awjlogan/emonTH3/models/12BH321P-GR.stp

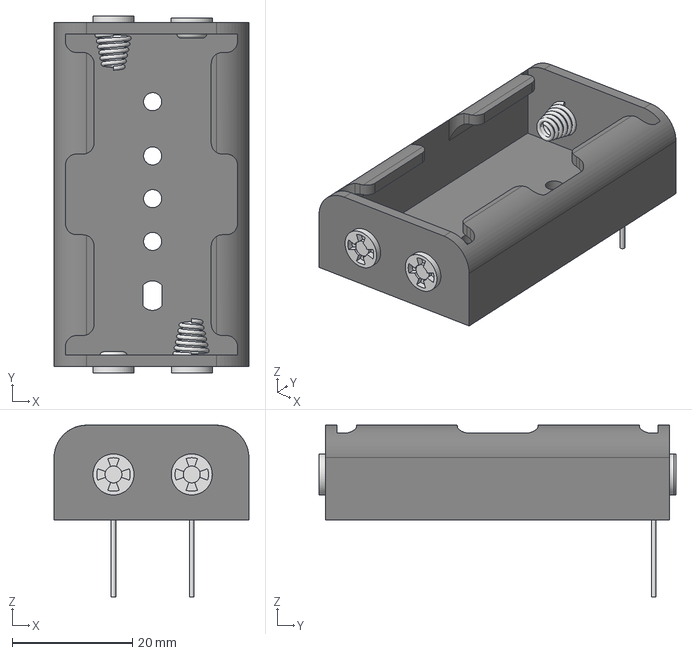
[picture p1: CAD file, 2024-12-10]
models/12BH321P-GR.stp
32.4 x 59.3 x 28.5 mm
