awjlogan/emonTH3/models/pxc_5441388_01_00_BCH-350H-6-GN_3D.stp

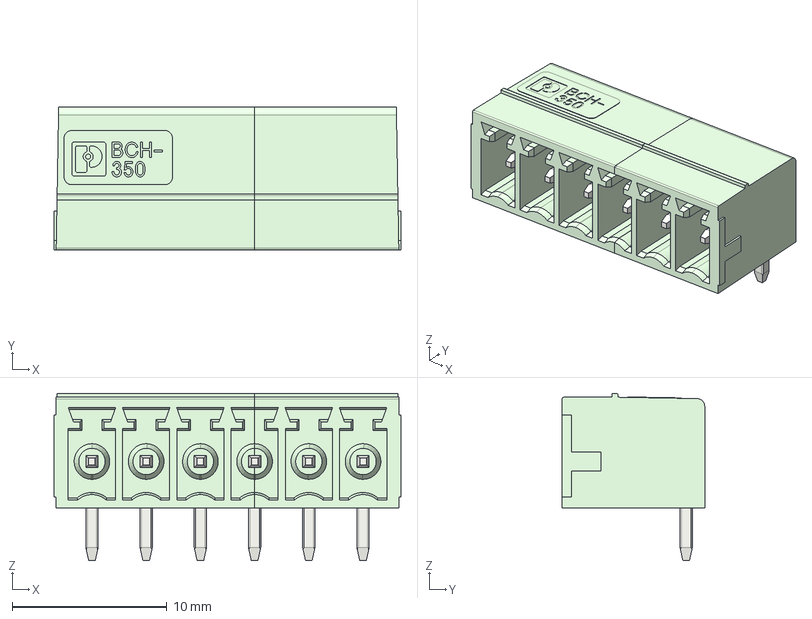
[picture p2: CAD file, 2024-11-21]
models/pxc_5441388_01_00_BCH-350H-6-GN_3D.stp
22.4 x 9.20 x 10.8 mm
