awjlogan/emonTH3/models/L_DND2020MK.STEP

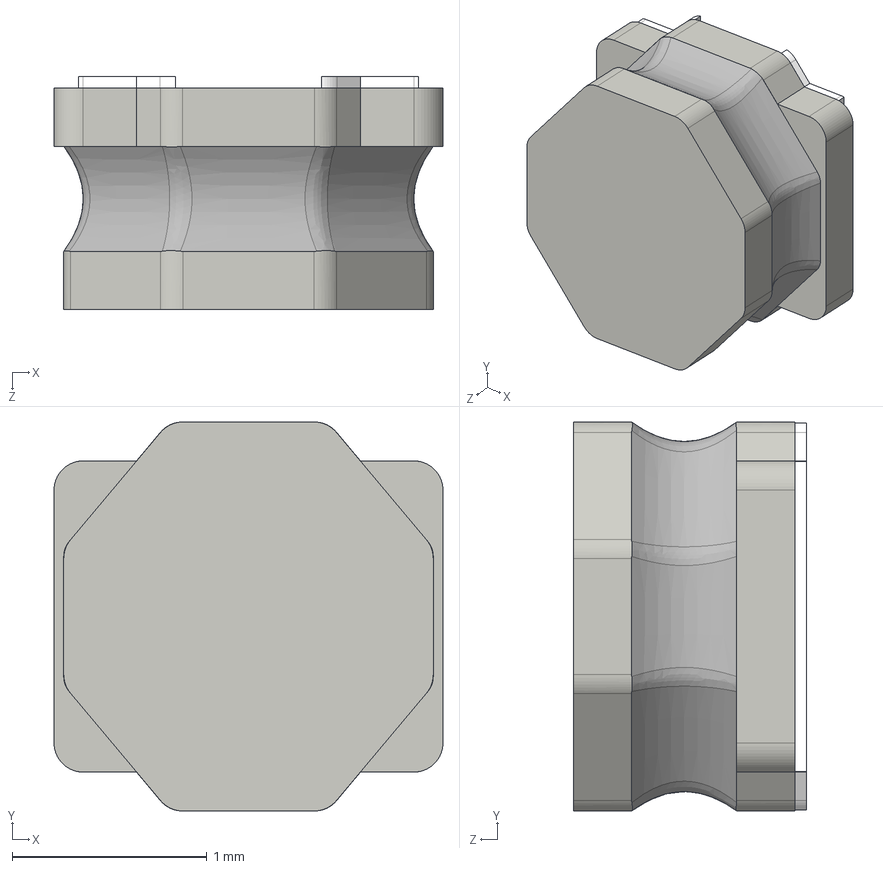
[picture p3: CAD file, 2024-11-21]
models/L_DND2020MK.STEP
2.00 x 2.00 x 1.20 mm
