awjlogan/emonTH3/models/pxc_5441359_01_00_BCH-350H-3-GN_3D.stp

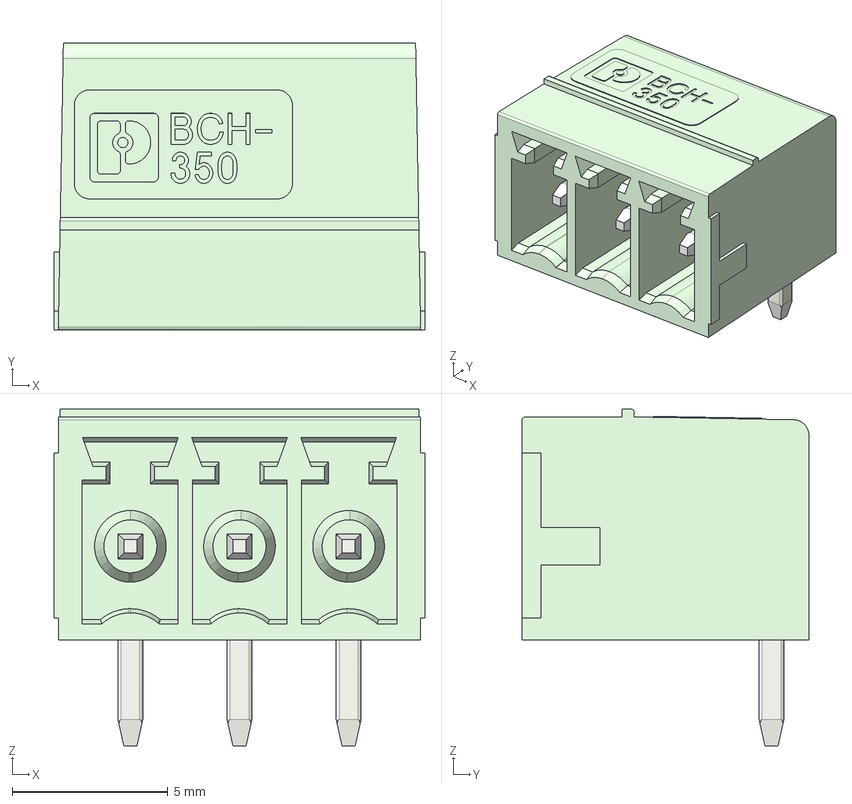
[picture p4: CAD file, 2024-11-21]
models/pxc_5441359_01_00_BCH-350H-3-GN_3D.stp
11.9 x 9.20 x 10.8 mm
