awjlogan/emonTH3/models/54601-906WPLFc.stp

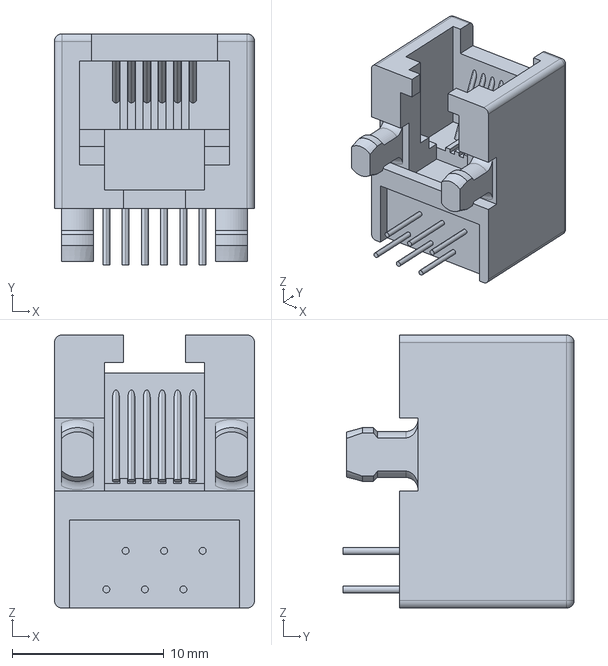
[picture p5: CAD file, 2024-11-21]
models/54601-906WPLFc.stp
13.2 x 15.2 x 18.0 mm
