awjlogan/emonTH3/models/TPS61291DRVR.stp

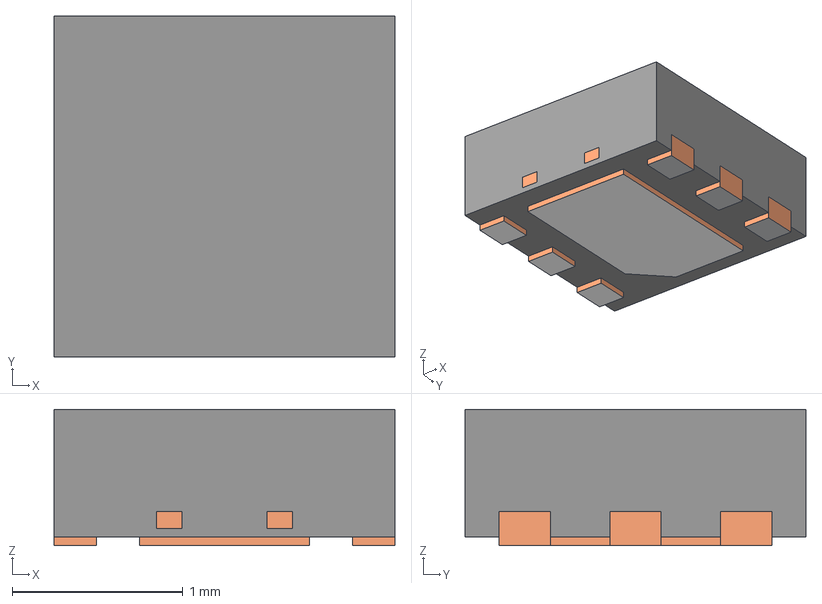
[picture p6: CAD file, 2024-11-21]
models/TPS61291DRVR.stp
2.00 x 2.00 x 0.8 mm
BODY-SON
FRAME-DRV0006A
PIN1-ID
