awjlogan/emonTH3/models/54602-908LFc.stp

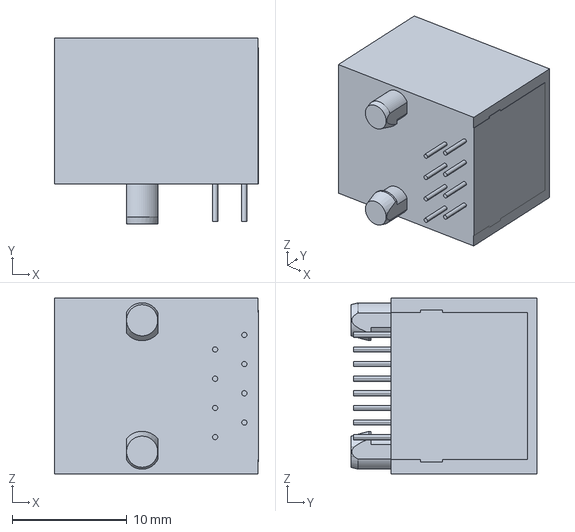
[picture p7: CAD file, 2024-11-21]
models/54602-908LFc.stp
17.7 x 16.2 x 15.3 mm
