awjlogan/emonTH3/models/132136-12.stp

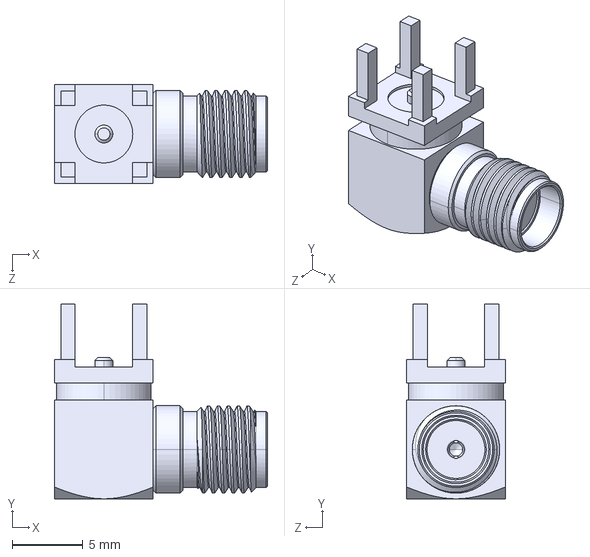
[picture p8: CAD file, 2024-11-21]
models/132136-12.stp
15.1 x 13.8 x 7.00 mm
