awjlogan/emonTH3/emonTH3-schematic.pdf

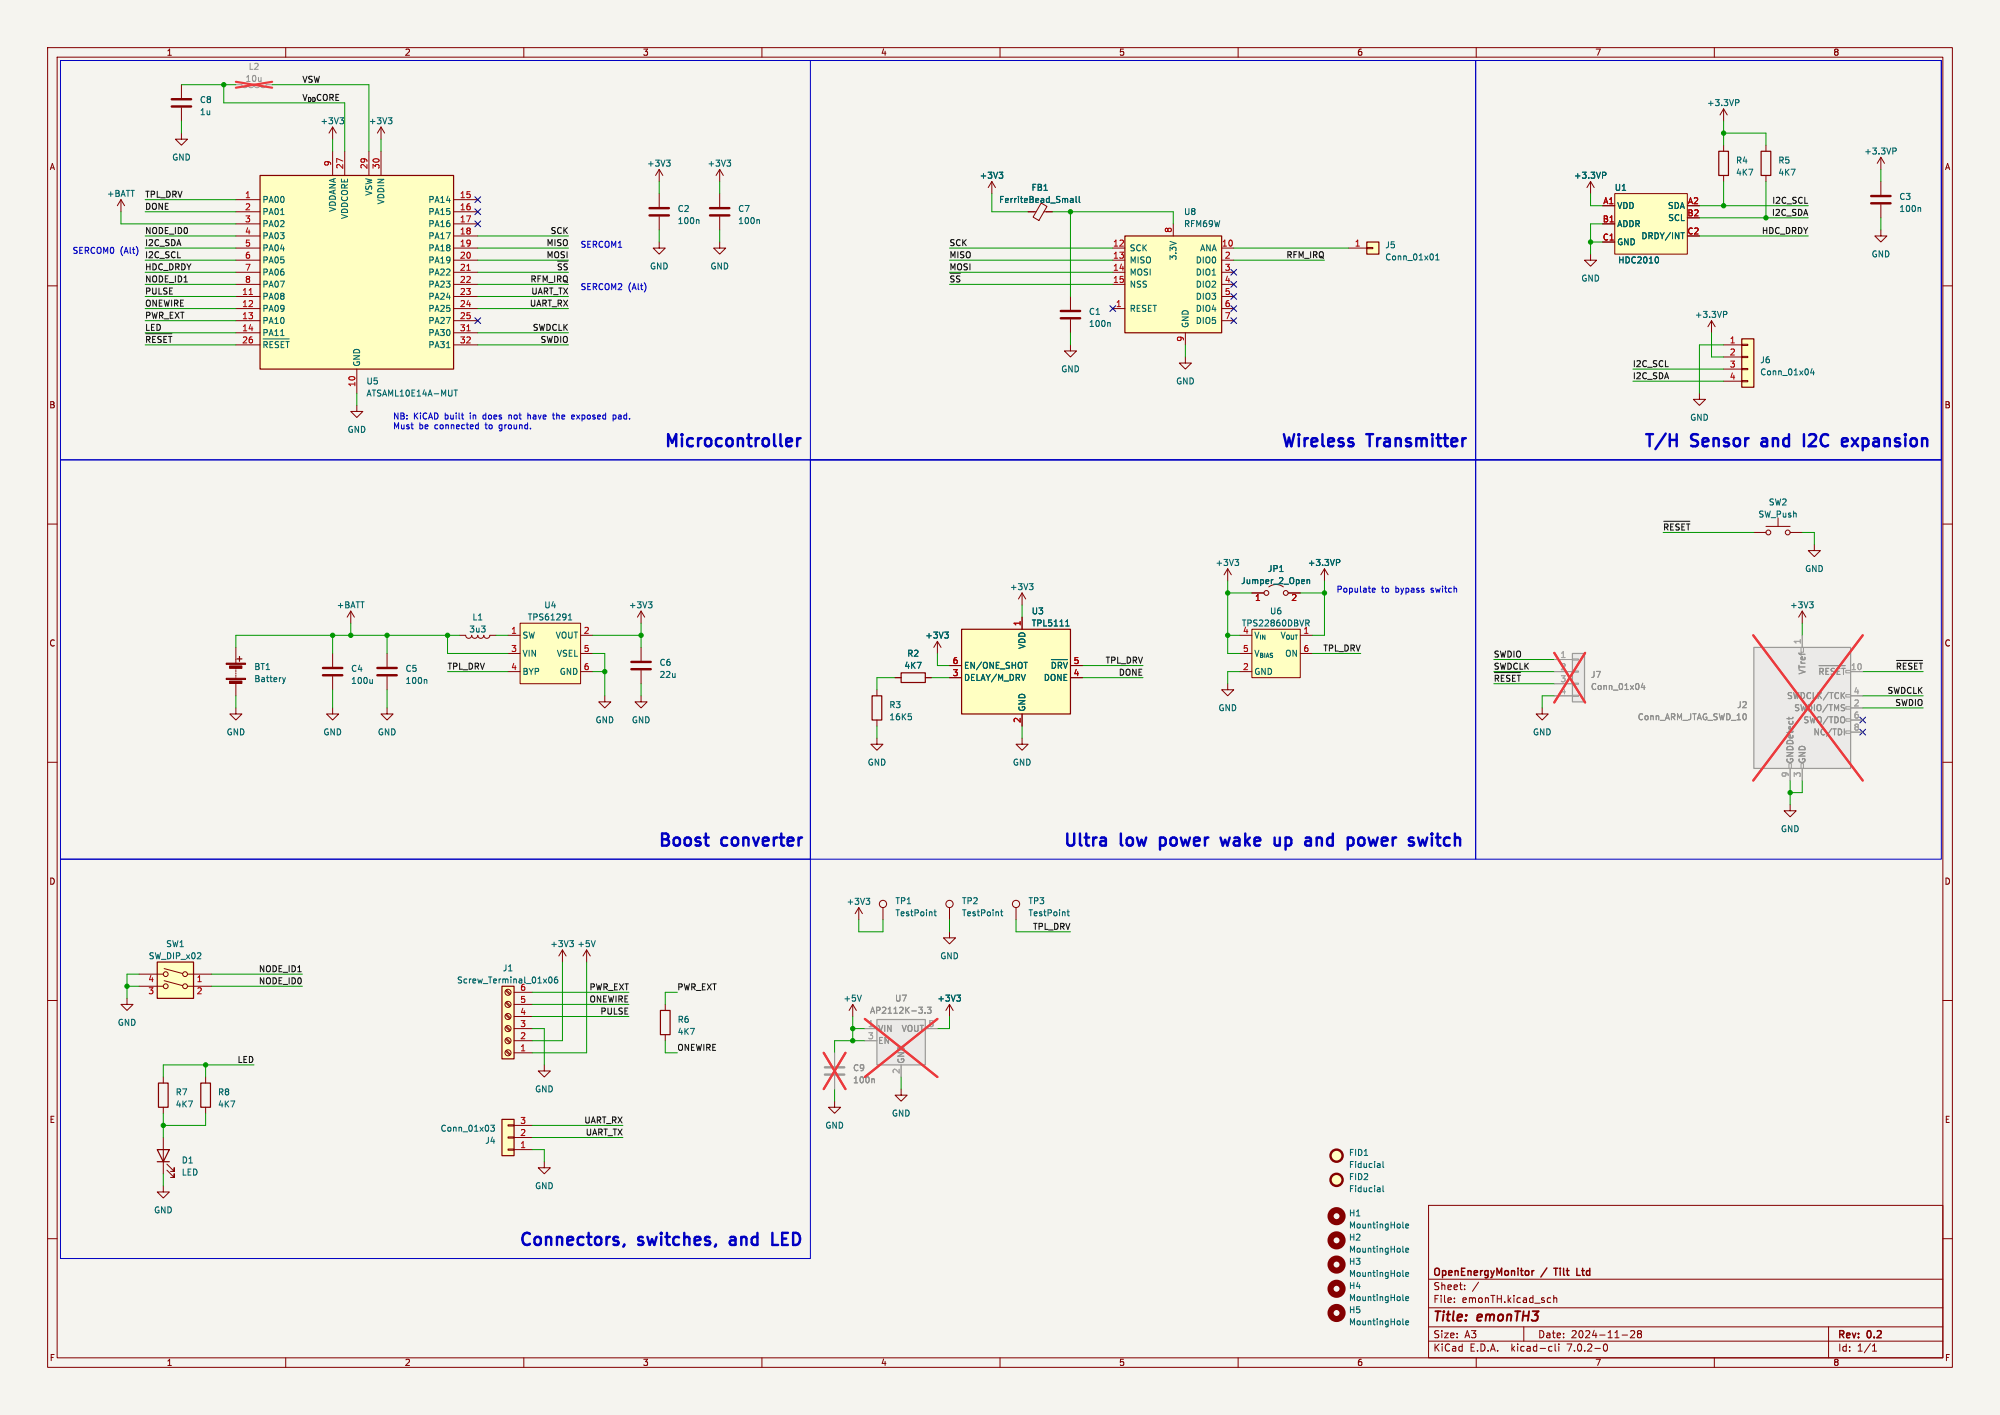
[picture p9: page 1]

Populate to bypass switch Wireless Transmitter

2 DELAY/M_DRV 3 DONE 4 ~{DRV}5 EN/ONE_SHOT 6 U3 TPL5111 R2

2 DELAY/M_DRV 3 DONE 4 ~{DRV}5 EN/ONE_SHOT 6 R2

Ultra low power wake up and power switch

2 EN 3 VOUT 5 U7 AP2112K-3.3 TP1 TestPoint GND
