awjlogan/emonTH3/emonTH3-floorplan.pdf

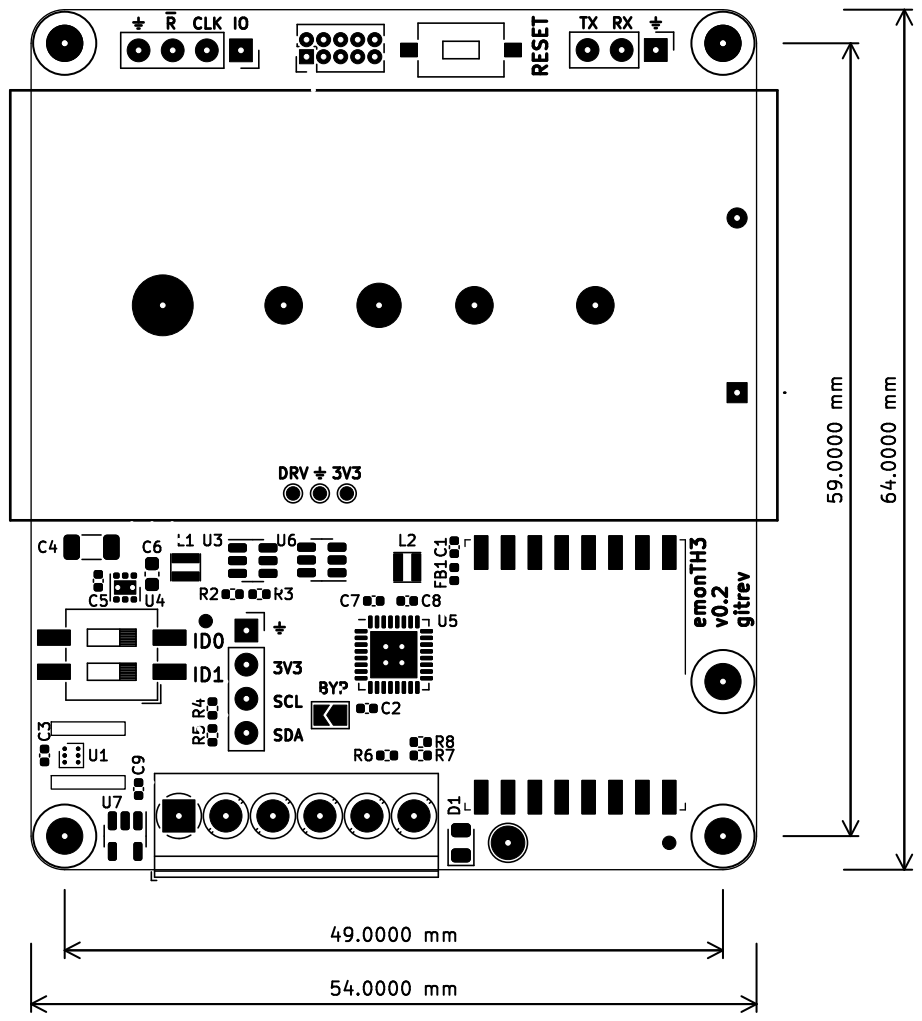
[picture p10: page 1]
