awjlogan/emonTH3/(commit log)

2024-11-21 * Initial commit
    - Use SAML10
    - Low power wake up schematic
    - Optional coin cell
    [132136-12.stp, 54601-906WPLFc.stp, 54602-908LFc.stp, L_DND2020MK.STEP, TPS61291DRVR.stp, emonTH.kicad_pcb, emonTH.kicad_sch, pxc_5441359_01_00_BCH-350H-3-GN_3D.stp]
2024-11-23 * Add I2C header and low power switch
    [emonTH.kicad_pcb, emonTH.kicad_sch]
2024-11-26 Final check for manufacture
    [emonTH.kicad_pcb, emonTH.kicad_sch]
2024-11-28 * Add generate and build
    [emonTH.kicad_pcb]
2024-11-30 * Update metadata and add license
    [emonTH.kicad_pcb, emonTH.kicad_sch]
2024-12-06 * Change to RFM69W - Add 3D model * Remove coax footprint * Remove coin cell footprint and protection diode
    [emonTH.kicad_pcb, emonTH.kicad_sch]
2024-12-10 * Move UART to same edge as emonTH * Add mounting hole for I2C expander board * Rationalise BoM (reuse 4K7 as much as possible)
    [12BH321P-GR.stp, emonTH.kicad_pcb, emonTH.kicad_sch]
2024-12-13 * Add additional 3V3 connector for Pi programming * Rotate AA holder for better routing * Move test pads from under AA holder * Extra via stitching * Update readme ready for Pi programming instructio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
    [emonTH.kicad_pcb, emonTH.kicad_sch]
2026-09-10 Update README with new sensor components
    Added new components including TI HDC2010 sensor and optional Sensirion SEK-STCC4 CO2 sensor.
